Lippsson/LED-Waage3.0/LED-Wasserwaage-Schaltung-2.0.png

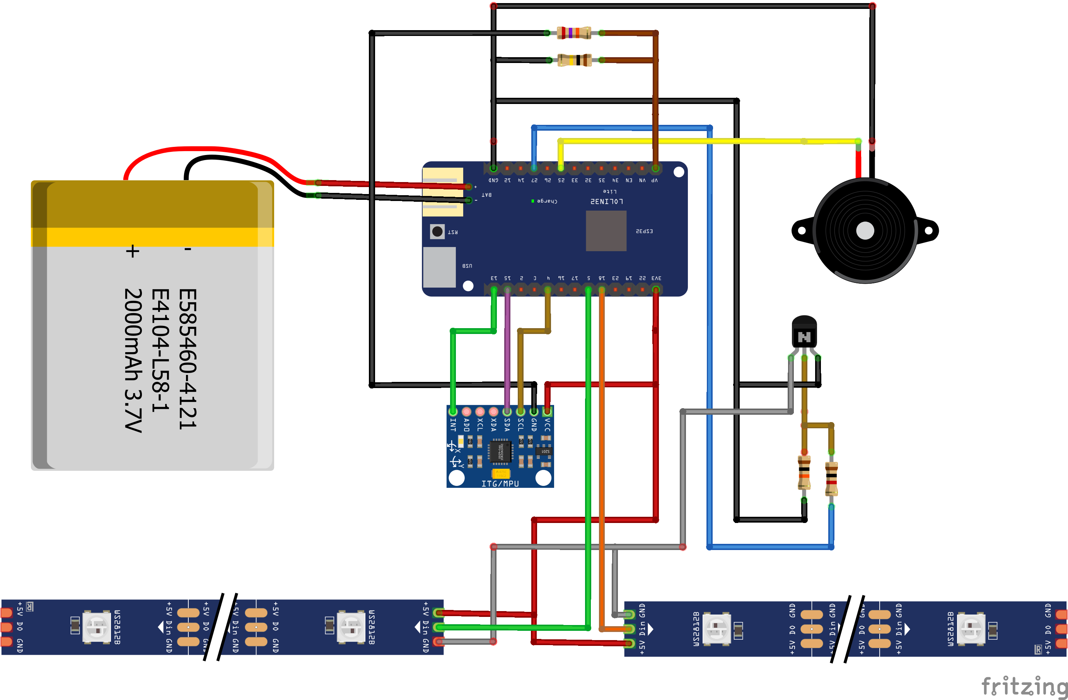
LED-Wasserwaage-Schaltung-2.0.png
