Lippsson/LED-Waage3.0/Volle breite_niwe.png

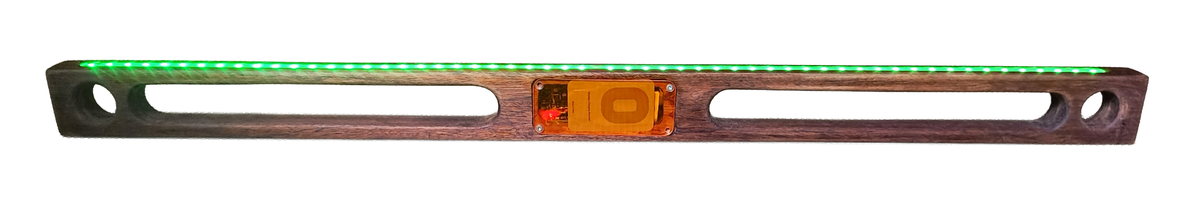
Volle breite_niwe.png
