Lippsson/LED-Waage3.0/(commit log)

2026-10-13 Add LED-Waage 3.0 firmware (BLE app interface, runtime settings, 2x44 LEDs, OLED)
    Based on the LED-Wasserwaage 2.0 sketch from Make Magazin.
2026-10-13 Add Android app, protocol docs and README for LED-Waage 3.0
    App code is MIT licensed (app/LICENSE). README credits the original LED-Waage2.0 project.
2026-10-13 Add wiring diagram with the SH1106 OLED display
    Based on the Fritzing diagram from the Make Magazin LED-Waage 2.0 (kept unchanged as LED-Wasserwaage-Schaltung-2.0.png).
2026-10-13 Add automatic power-off (deep sleep) with OLED off and no sleep while the app is connected
    New setting sleepMin (0 = off), shown in the app under Settings > Device. README and protocol docs updated.
